PaulGuillemin/stm32-ecg-monitor/docs/reports/ecg-presentation-2025.pdf

## Système embarqué d’acquisition et affichage d’un signal ECG

Lecourtois Tristan - Guillemin Paul

Ecole Nationale Supérieure des Mines de Saint- ´ | Etienne ´

27 mars 2025

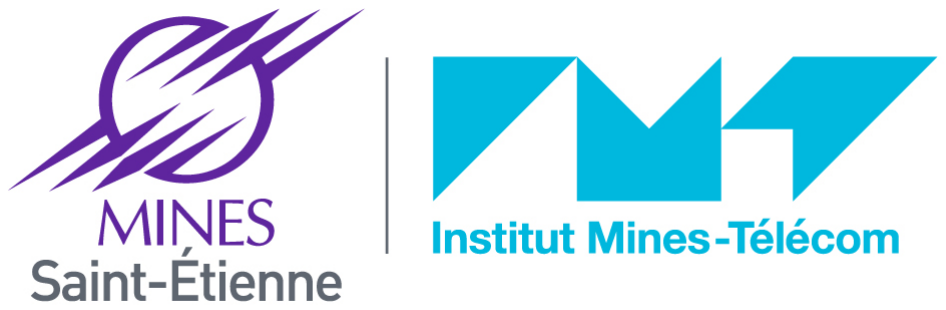
[picture p22: figure]

Lecourtois Tristan - Guillemin Paul (Ecole Nationale Supérieure des Mines de Saint- ´ | Projet ECG | Etienne) ´ | 27 mars 2025 | 1 / 11

## Sommaire

1 | Introduction
2 | Méthodes et Techniques Technologies en Salle Blanche Electronique ´ Expérimentations et Mesures
3 | Traitement du Signal
4 | Le Démonstrateur Technologique
Lecourtois Tristan - Guillemin Paul (Ecole Nationale Supérieure des Mines de Saint- ´ | Projet ECG | Etienne) ´ | 27 mars 2025 | 2 / 11

## Contexte et Objectifs

Objectif du projet : Conception d’un prototype embarqué pour l’acquisition et l’affichage d’un signal ECG.
Etapes principales du projet ´ | :
| Fabrication des électrodes ECG et de la matrice OLED en salle blanche. Réalisation de l’électronique de conditionnement et de multiplexage. Programmation du microcontrôleur pour le traitement du signal et son

affichage.
Objectifs pédagogiques :
| Découverte des technologies de fabrication en salle blanche. Approfondissement des compétences en électronique de conditionnement et en programmation. Mise en pratique des concepts de systèmes embarqués dans un

contexte réel.

Lecourtois Tristan - Guillemin Paul (Ecole Nationale Supérieure des Mines de Saint- ´ | Projet ECG | Etienne) ´ | 27 mars 2025 | 3 / 11

## Méthodes de Fabrication

Photolithographie : Technique de fabrication utilisant un masque et une lumière UV pour transférer un motif sur un matériau photosensible.
Spin-coating : Application d’une couche mince uniforme d’un polymère sur un substrat par rotation rapide.
Evaporation sous vide ´ | : Dépôt
d’une couche métallique sous vide pour assurer une haute pureté et une bonne adhérence.

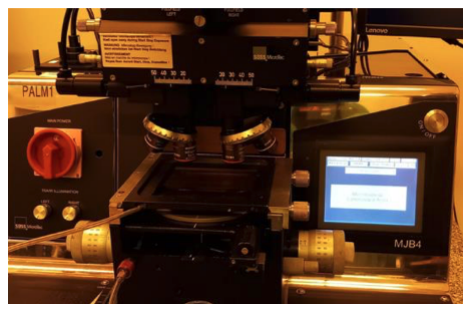
[picture p23: figure]

Figure – Photolithographie


Figure – Spin-coating

Lecourtois Tristan - Guillemin Paul (Ecole Nationale Supérieure des Mines de Saint- ´ | Projet ECG | Etienne) ´ | 27 mars 2025 | 4 / 11

## Evaporation sous vide ´

Procédé de dépôt de couches minces sous vide poussé
Technique essentielle pour la microfabrication


Figure – Evaporation sous vide ´

Lecourtois Tristan - Guillemin Paul (Ecole Nationale Supérieure des Mines de Saint- ´ | Projet ECG | Etienne) ´ | 27 mars 2025 | 5 / 11

## Ellipsométrie et Microscopie à Force Atomique

Ellipsométrie : Permet de mesurer l’épaisseur et l’indice de réfraction des couches minces par interaction lumière-matière. Microscopie à Force
Atomique (AFM) : Technique
de caractérisation pour analyser
la topographie des surfaces à

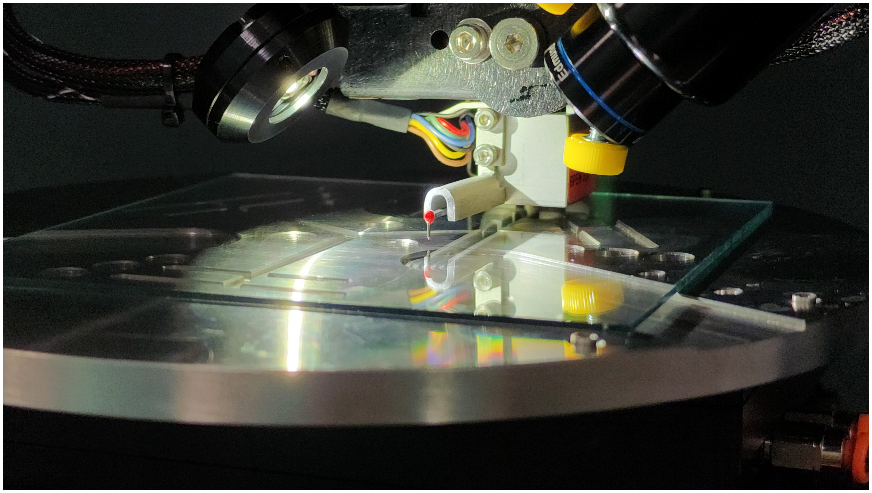
[picture p24: figure]

l’échelle nanométrique. | Figure – Microscopie à force atomique
Lecourtois Tristan - Guillemin Paul (Ecole Nationale Supérieure des Mines de Saint- ´ | Projet ECG | Etienne) ´ | 27 mars 2025 | 6 / 11

## Conception des Cartes Electroniques ´

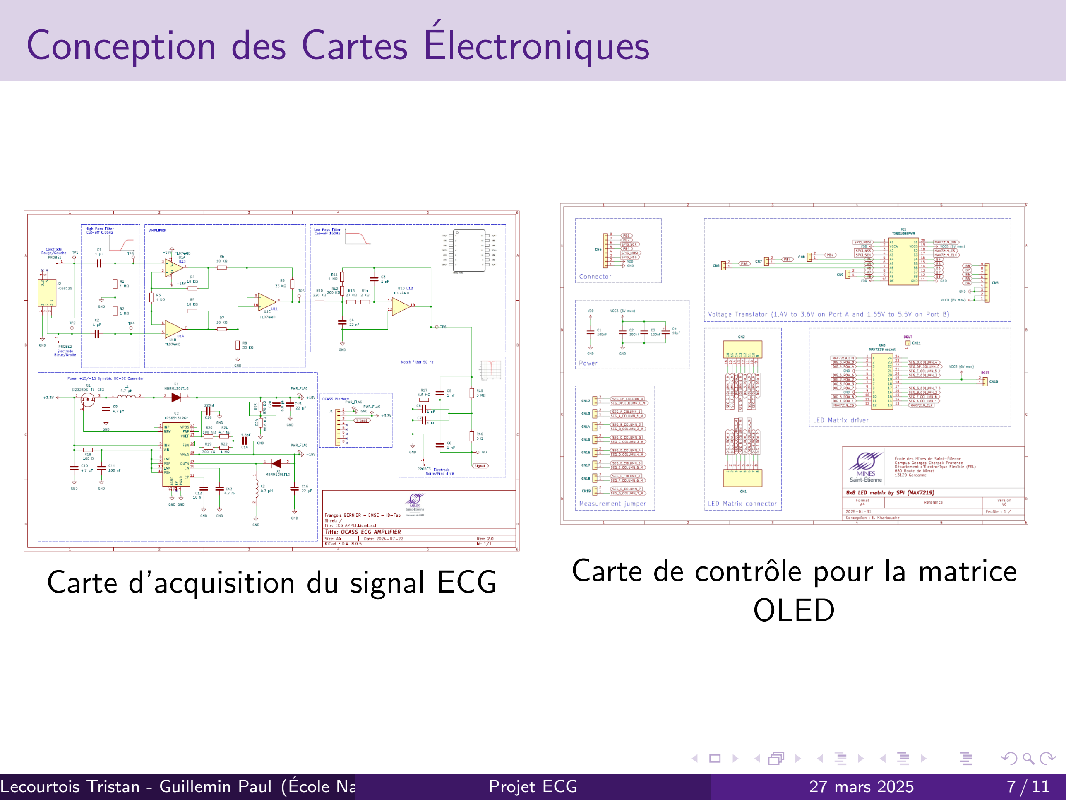
[picture p25: page 7]

Carte d’acquisition du signal ECG | Carte de contrôle pour la matrice OLED
Lecourtois Tristan - Guillemin Paul (Ecole Nationale Supérieure des Mines de Saint- ´ | Projet ECG | Etienne) ´ | 27 mars 2025 | 7 / 11

## Validation Expérimentale

Signal ECG mesuré à

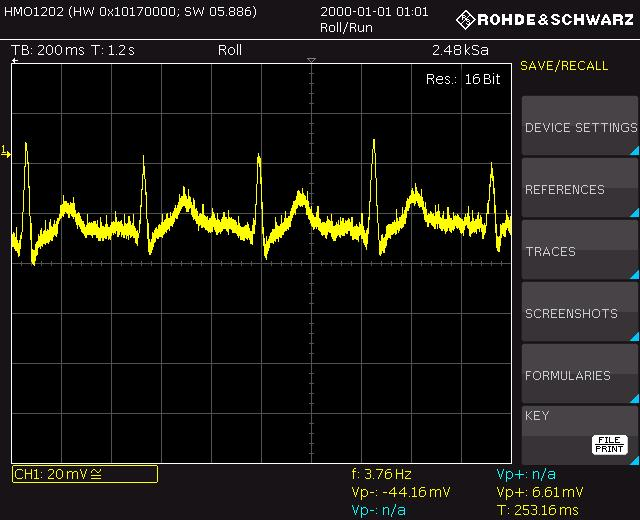
[picture p26: figure]

l’oscilloscope

Lecourtois Tristan - Guillemin Paul (Ecole Nationale Supérieure des Mines de Saint- ´ | Projet ECG | Etienne) ´ | 27 mars 2025 | 8 / 11

## Acquisition et Filtrage du Signal


Acquisition du signal : Les électrodes ECG captent les variations de potentiel électrique du cœur.
Prétraitement : Un filtre passe-bas et une moyenne
glissante sont appliqués pour réduire le bruit.


Lecourtois Tristan - Guillemin Paul (Ecole Nationale Supérieure des Mines de Saint- ´ | Projet ECG | Etienne) ´ | 27 mars 2025 | 9 / 11

## Signal Final Avant Extraction


Signal en fin de traitement avant d’extraire la périodicité des pics R

Lecourtois Tristan - Guillemin Paul (Ecole Nationale Supérieure des Mines de Saint- ´ | Projet ECG | Etienne) ´ | 27 mars 2025 | 10 / 11

## Présentation des Fonctionnalités

Filtrage et amélioration du signal ECG

Détection des pics de rythme cardiaque Affichage sur la matrice OLED

Visualisation et communication UART

Lecourtois Tristan - Guillemin Paul (Ecole Nationale Supérieure des Mines de Saint- ´ | Projet ECG | Etienne) ´ | 27 mars 2025 | 11 / 11
