PaulGuillemin/stm32-ecg-monitor/docs/media/ecg-oscilloscope.jpg

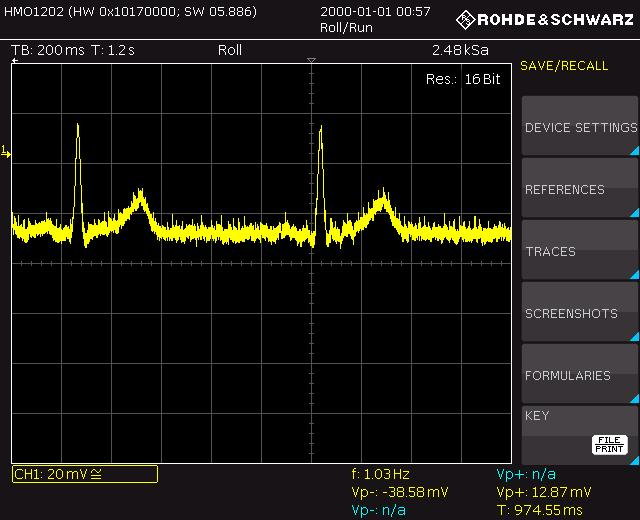
docs/media/ecg-oscilloscope.jpg
