PaulGuillemin/stm32-ecg-monitor/hardware/led-matrix-layer.png

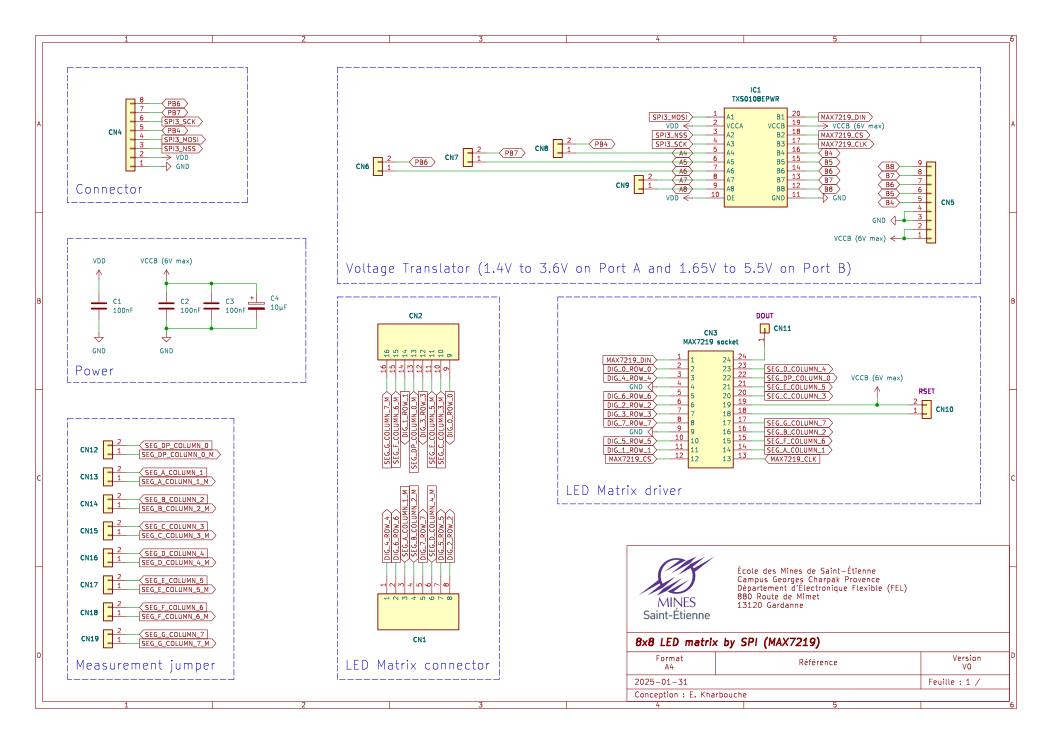
hardware/led-matrix-layer.png
