PaulGuillemin/stm32-ecg-monitor/firmware/Core/Src/main.c

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
/* Includes ------------------------------------------------------------------*/
#include "main.h"

/* USER CODE BEGIN Includes */
#include <string.h>
#include <stdio.h>
#include <stdlib.h>

#include "DOT_MATRIX.h"
/* USER CODE END Includes */

/* USER CODE BEGIN PD */
//////////////////////////////////////////// VARIABLES BPM ////////////////////////////////////////////
#define MAX_BPM 250
#define MIN_BPM 40
#define MAX_CHAR_LENGTH 10

#define ADC_BUFFER_SIZE 512
#define MOVING_AVERAGE_WINDOW 25
#define OUTLIER_THRESHOLD 0.2
#define DERIVATIVE_THRESHOLD 500
#define R_PEAK_THRESHOLD 45000
#define REFRACTORY_PERIOD 300

#define MATRIX_DISPLAY_UNIT1  0
/* USER CODE END PD */

ADC_HandleTypeDef hadc1;

SPI_HandleTypeDef hspi3;

TIM_HandleTypeDef htim6;
TIM_HandleTypeDef htim7;
TIM_HandleTypeDef htim15;
TIM_HandleTypeDef htim16;

UART_HandleTypeDef huart1;

/* USER CODE BEGIN PV */
uint16_t adc_buffer[ADC_BUFFER_SIZE];
uint16_t moving_average_buffer[MOVING_AVERAGE_WINDOW];
char buffer[10];
uint8_t buffer_index = 0;
uint16_t previous_value = 0;
int16_t previous_derivative = 0;
volatile uint16_t refractory_counter = 0;
uint32_t bpm = 5;
char MSG[MAX_CHAR_LENGTH] = "";
uint8_t increment_affichage = 0;
/* USER CODE END PV */

void SystemClock_Config(void);
static void MX_GPIO_Init(void);
static void MX_ADC1_Init(void);
static void MX_USART1_UART_Init(void);
static void MX_TIM6_Init(void);
static void MX_TIM7_Init(void);
static void MX_SPI3_Init(void);
static void MX_TIM16_Init(void);
static void MX_TIM15_Init(void);
/* USER CODE BEGIN PFP */
uint16_t low_pass_filter(uint16_t input);
uint16_t moving_average_filter(uint16_t input);
uint16_t remove_outliers(uint16_t input);
uint16_t remove_spikes(uint16_t input);
void detect_r_peak(uint16_t input, int16_t derivative);
/* USER CODE END PFP */

/**
  * @brief  The application entry point.
  * @retval int
  */
int main(void)
{

  /* MCU Configuration--------------------------------------------------------*/

  /* Reset of all peripherals, Initializes the Flash interface and the Systick. */
  HAL_Init();

  /* Configure the system clock */
  SystemClock_Config();

  /* Initialize all configured peripherals */
  MX_GPIO_Init();
  MX_ADC1_Init();
  MX_USART1_UART_Init();
  MX_TIM6_Init();
  MX_TIM7_Init();
  MX_SPI3_Init();
  MX_TIM16_Init();
  MX_TIM15_Init();
  /* USER CODE BEGIN 2 */
  HAL_ADC_Start_IT(&hadc1);
  HAL_TIM_Base_Start_IT(&htim6);
  HAL_TIM_Base_Start(&htim7);

  DOT_MATRIX_Init_TMR(&hspi3, &htim16);
  MATRIX_DisplayMessage(0, MSG, sizeof(MSG));
  /* USER CODE END 2 */

  /* Infinite loop */
  /* USER CODE BEGIN WHILE */
  while (1)
  {
    /* USER CODE END WHILE */

    /* USER CODE BEGIN 3 */

  }
  /* USER CODE END 3 */
}

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
/* USER CODE BEGIN 4 */
uint16_t low_pass_filter(uint16_t input) {
    static uint16_t previous_output = 0;
    previous_output = (previous_output * 15 + input) / 16;
    return previous_output;
}

uint16_t moving_average_filter(uint16_t input) {
    static uint32_t sum = 0;
    sum -= moving_average_buffer[buffer_index];
    moving_average_buffer[buffer_index] = input;
    sum += input;
    buffer_index = (buffer_index + 1) % MOVING_AVERAGE_WINDOW;
    return sum / MOVING_AVERAGE_WINDOW;
}

uint16_t remove_spikes(uint16_t input) {
    uint16_t derivative = abs(input - previous_value);
    previous_value = input;

    if (derivative > DERIVATIVE_THRESHOLD) {
        return previous_value;
    }
    return input;
}

uint16_t remove_outliers(uint16_t input) {
    static uint16_t values[MOVING_AVERAGE_WINDOW];
    static uint8_t index = 0;
    values[index] = input;
    index = (index + 1) % MOVING_AVERAGE_WINDOW;

    uint16_t sorted[MOVING_AVERAGE_WINDOW];
    memcpy(sorted, values, sizeof(values));
    for (int i = 0; i < MOVING_AVERAGE_WINDOW - 1; i++) {
        for (int j = i + 1; j < MOVING_AVERAGE_WINDOW; j++) {
            if (sorted[i] > sorted[j]) {
                uint16_t temp = sorted[i];
                sorted[i] = sorted[j];
                sorted[j] = temp;
            }
        }
    }

    uint16_t q1 = sorted[MOVING_AVERAGE_WINDOW / 4];
    uint16_t q3 = sorted[3 * MOVING_AVERAGE_WINDOW / 4];
    uint16_t iqr = q3 - q1;
    uint16_t lower_bound = q1 - OUTLIER_THRESHOLD * iqr;
    uint16_t upper_bound = q3 + OUTLIER_THRESHOLD * iqr;

    uint16_t median = sorted[MOVING_AVERAGE_WINDOW / 2];
    if (input < lower_bound || input > upper_bound) {
        return median;
    }
    return input;
}

uint32_t square_signal(uint16_t input) {
    return (uint32_t)input * (uint32_t)input;
}

void detect_r_peak(uint16_t input, int16_t derivative) {
    static uint8_t peak_detected = 0;
    static uint16_t refractory_counter = 0;

    if (refractory_counter > 0) {
            refractory_counter--;
            return;
        }

    if (input > R_PEAK_THRESHOLD) {
        if (!peak_detected) {
        	increment_affichage+=1;
            HAL_GPIO_WritePin(GPIOB, LED_Pin, GPIO_PIN_SET);
            HAL_TIM_Base_Start_IT(&htim6);

            uint32_t peak_period = __HAL_TIM_GET_COUNTER(&htim7);
            bpm = 600000/peak_period;

            if (increment_affichage == 3) {
            	sprintf(MSG, "BPM %3ld", bpm);
            	increment_affichage = 0;
            }


            __HAL_TIM_SET_COUNTER(&htim7, 0);
            peak_detected = 1;
            refractory_counter = REFRACTORY_PERIOD;
        }
    }
    else if (previous_derivative < 0 && derivative > 0) {
        peak_detected = 0;
    }

    previous_derivative = derivative;
}

void HAL_ADC_ConvCpltCallback(ADC_HandleTypeDef* hadc) {
    if (hadc->Instance == ADC1) {

        uint16_t adc_value = HAL_ADC_GetValue(&hadc1);
        uint16_t filtered_value = square_signal(moving_average_filter(low_pass_filter(remove_outliers(remove_spikes(adc_value)))));
        int16_t derivative = filtered_value - previous_value;
        previous_value = filtered_value;

        detect_r_peak(filtered_value, derivative);

        sprintf(buffer, "%d\r\n", filtered_value);
        HAL_UART_Transmit(&huart1, (uint8_t*)buffer, strlen(buffer), HAL_MAX_DELAY);

        HAL_ADC_Start_IT(&hadc1);
    }
}

void HAL_TIM_PeriodElapsedCallback(TIM_HandleTypeDef *htim) {
    if (htim->Instance == TIM6) {
        HAL_GPIO_WritePin(GPIOB, LED_Pin, GPIO_PIN_RESET);
        HAL_TIM_Base_Stop_IT(&htim6);
    }
    if (htim->Instance == TIM16) {
    	MATRIX_TMR_OVF_ISR(htim);
    }
}
/* USER CODE END 4 */
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
